sstapfer/CNCInterface/README.txt

Project CNCInterface
********************

Ethernetinterface to a CNC drilling machine using an Arduino Mega, an Ethernet shield and
a custom shield for RS232 and an LCD.
