sstapfer/CNCInterface/(commit log)

2013-02-14 fixed some bugs and added documentation
    [CNCHandler.ino, CNCInterface.ino, Streaming.ino, UI.ino, UserHandler.ino]
2013-02-15 moved Z axis testpoint on border of PCB
2013-03-20 added file delete function and improved buttons
    buttons are now debounced, files on sdcard can be deleted using the
    local lcd & keys. A message is displayed if no files are on sdcard
